PerlPooch/TimeMachine/Hardware/PCB/PCB Back.pdf

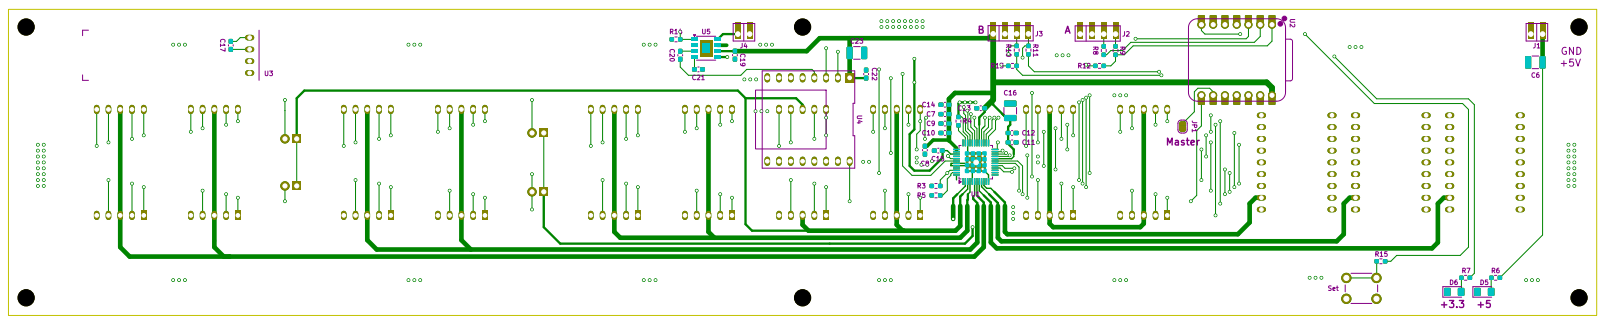
[picture p1: page 1]

Size: USLedger | Rev:
KiCad E.D.A. 10.0.6 | Id: 1/1
