PerlPooch/TimeMachine/Hardware/PCB/PCB Front.pdf

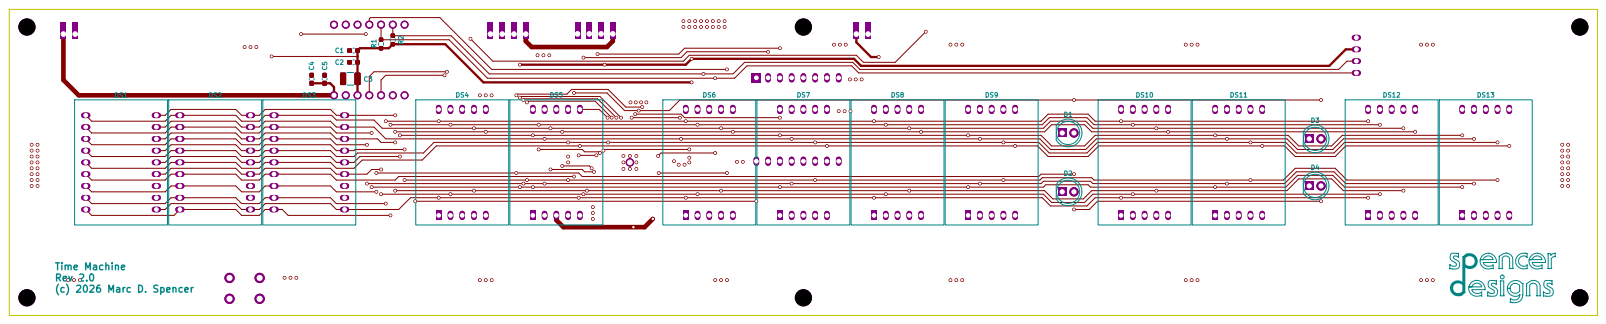
[picture p2: page 1]

Size: USLedger | Rev:
KiCad E.D.A. 10.0.6 | Id: 1/1
