PerlPooch/TimeMachine/Hardware/PCB/PCB.pdf

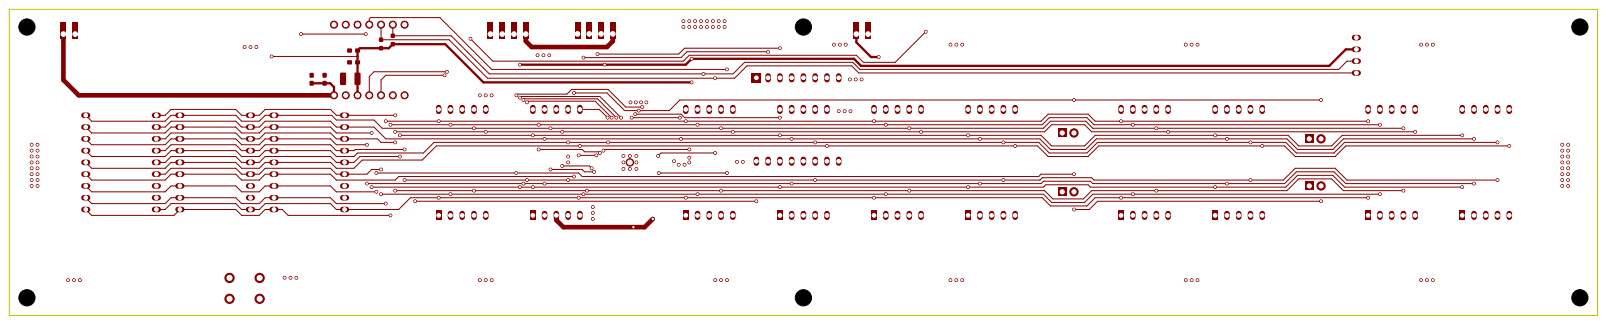
[picture p3: page 1]

Size: USLedger | Rev:
KiCad E.D.A. 10.0.6 | Id: 1/8

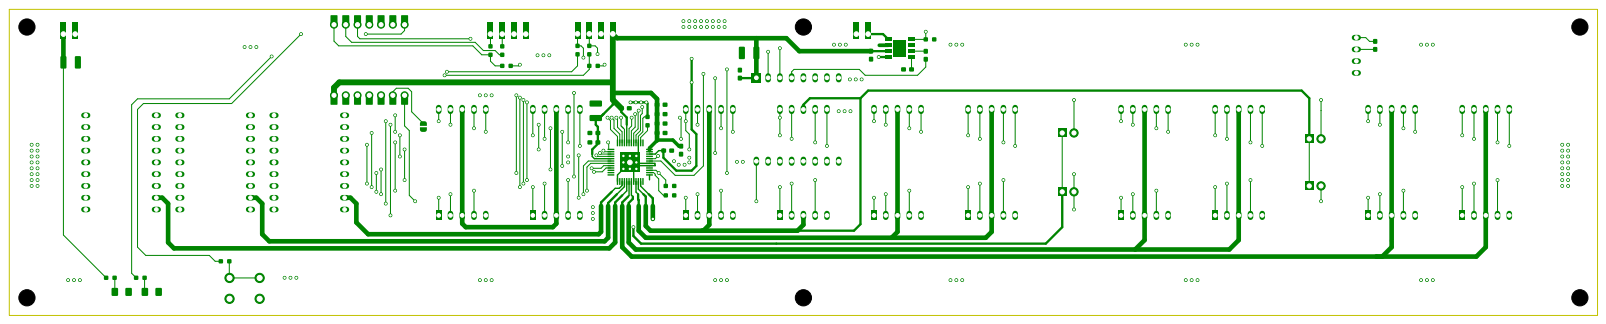
[picture p4: page 2]

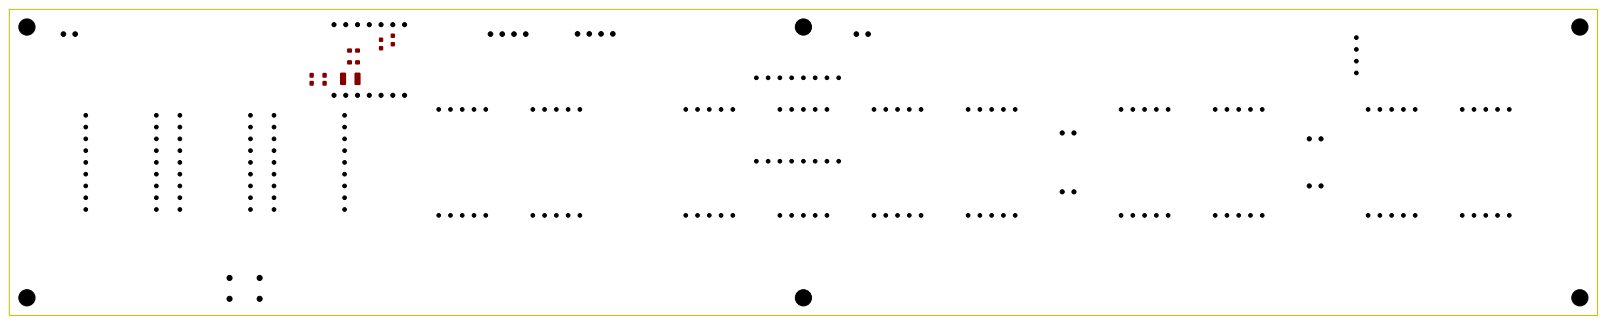
[picture p5: page 3]

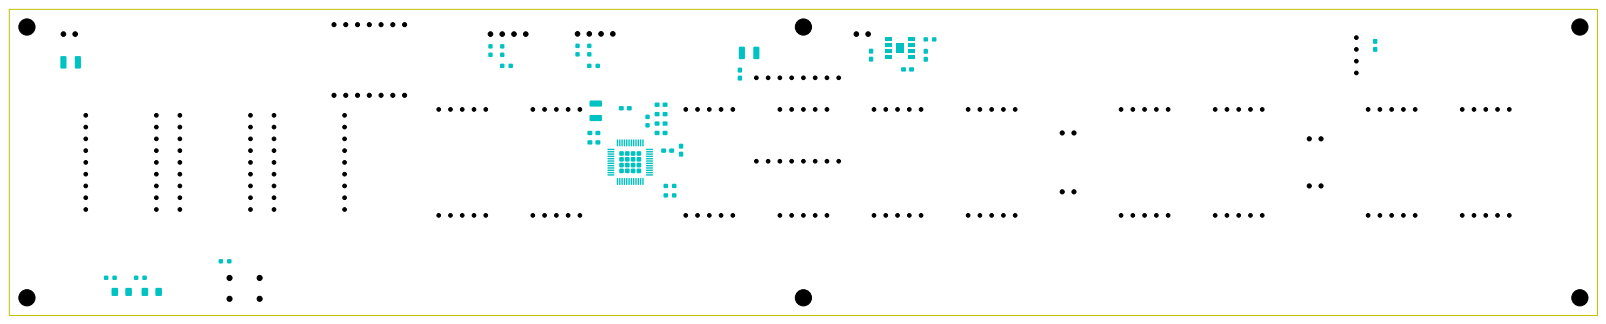
[picture p6: page 4]

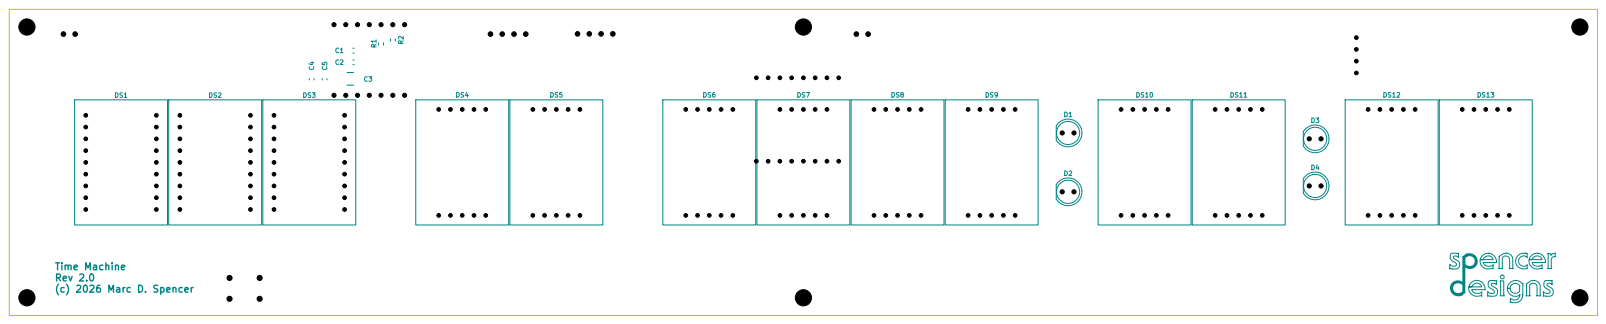
[picture p7: page 5]

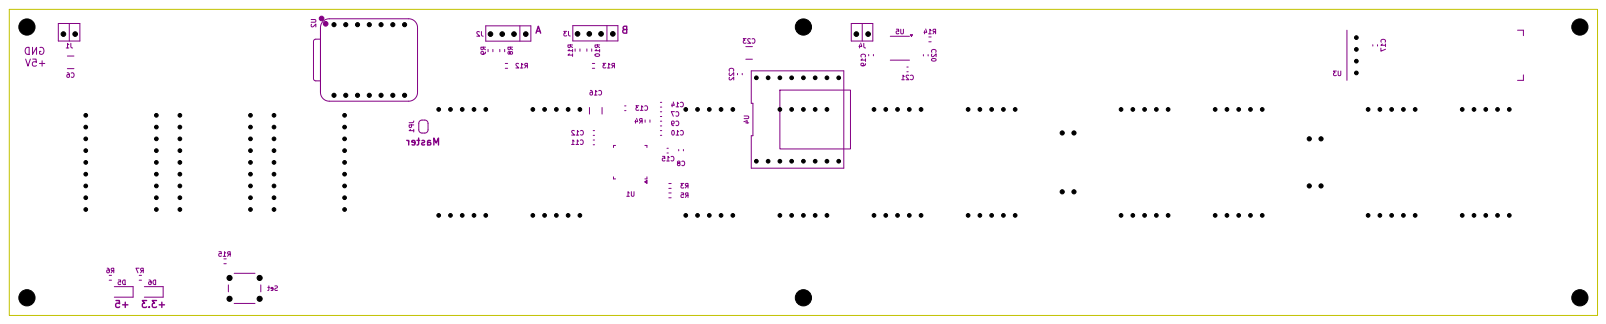
[picture p8: page 6]

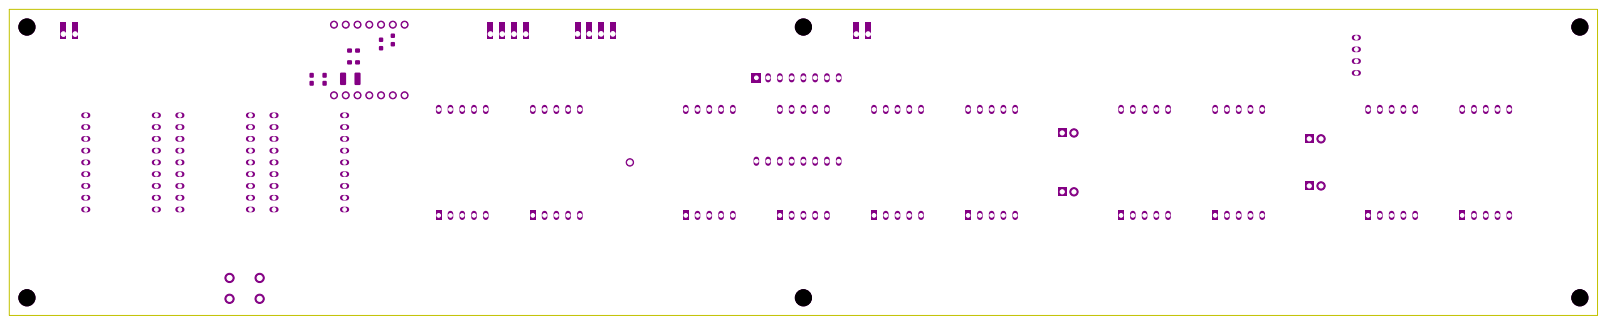
[picture p9: page 7]

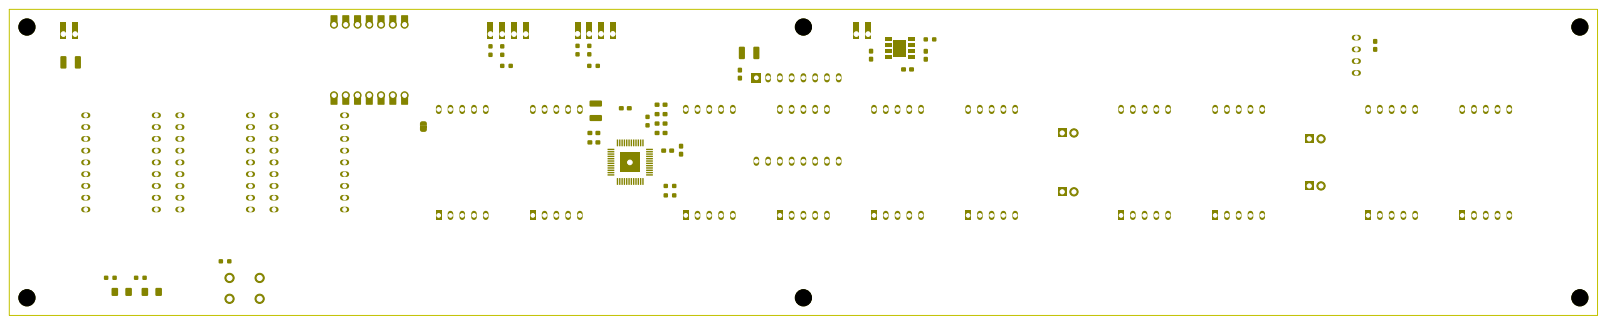
[picture p10: page 8]
