PerlPooch/TimeMachine/Hardware/PCB/Schematic.pdf

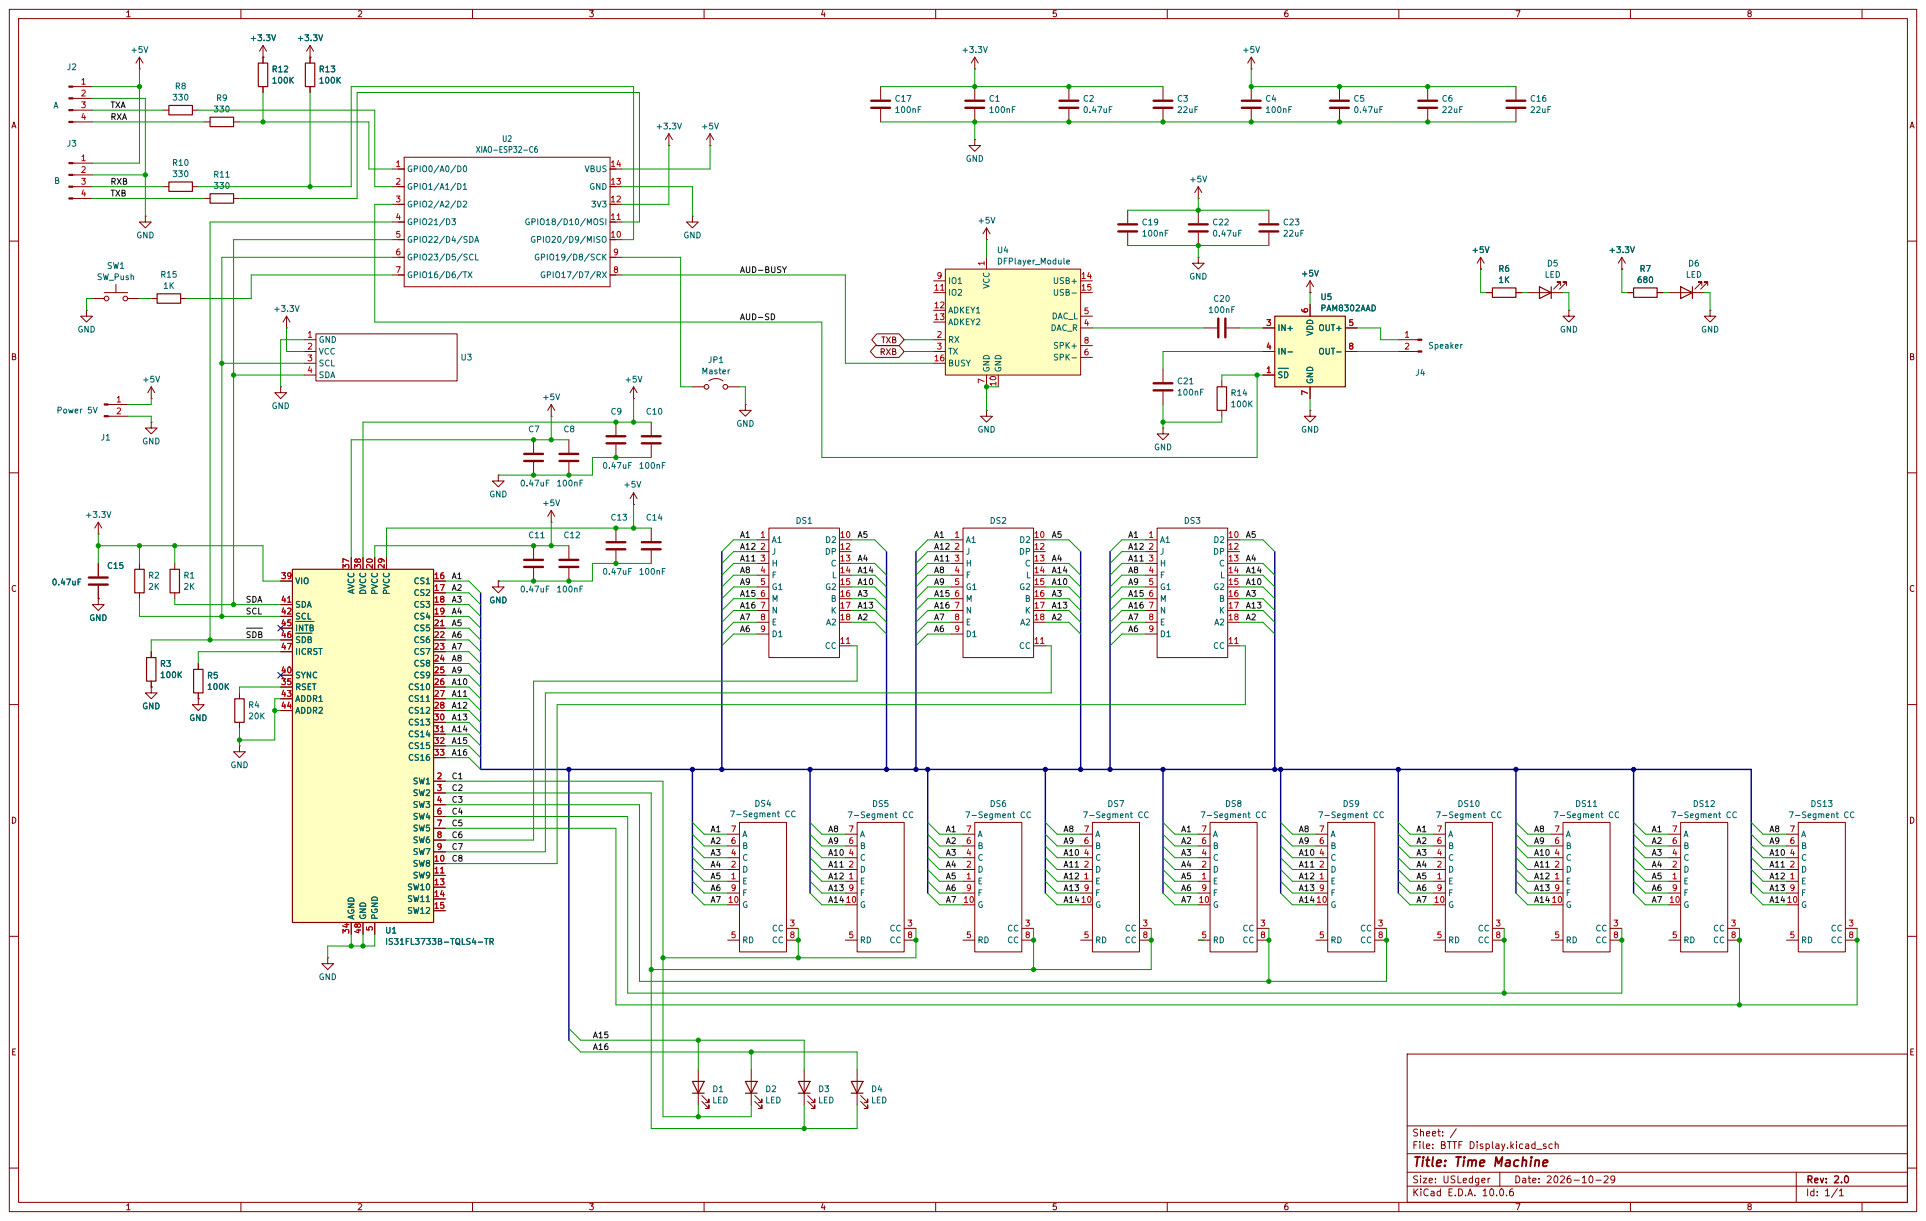
[picture p11: page 1]

SCL 42 | A4
INTB 45 | A5

Size: USLedger | Rev: 2.0
KiCad E.D.A. 10.0.6 | Id: 1/1
