PerlPooch/TimeMachine/Hardware/PCB/BTTF Display.kicad_pcb

## KiCad design Hardware/PCB/BTTF Display.kicad_pcb (2026-11-01)

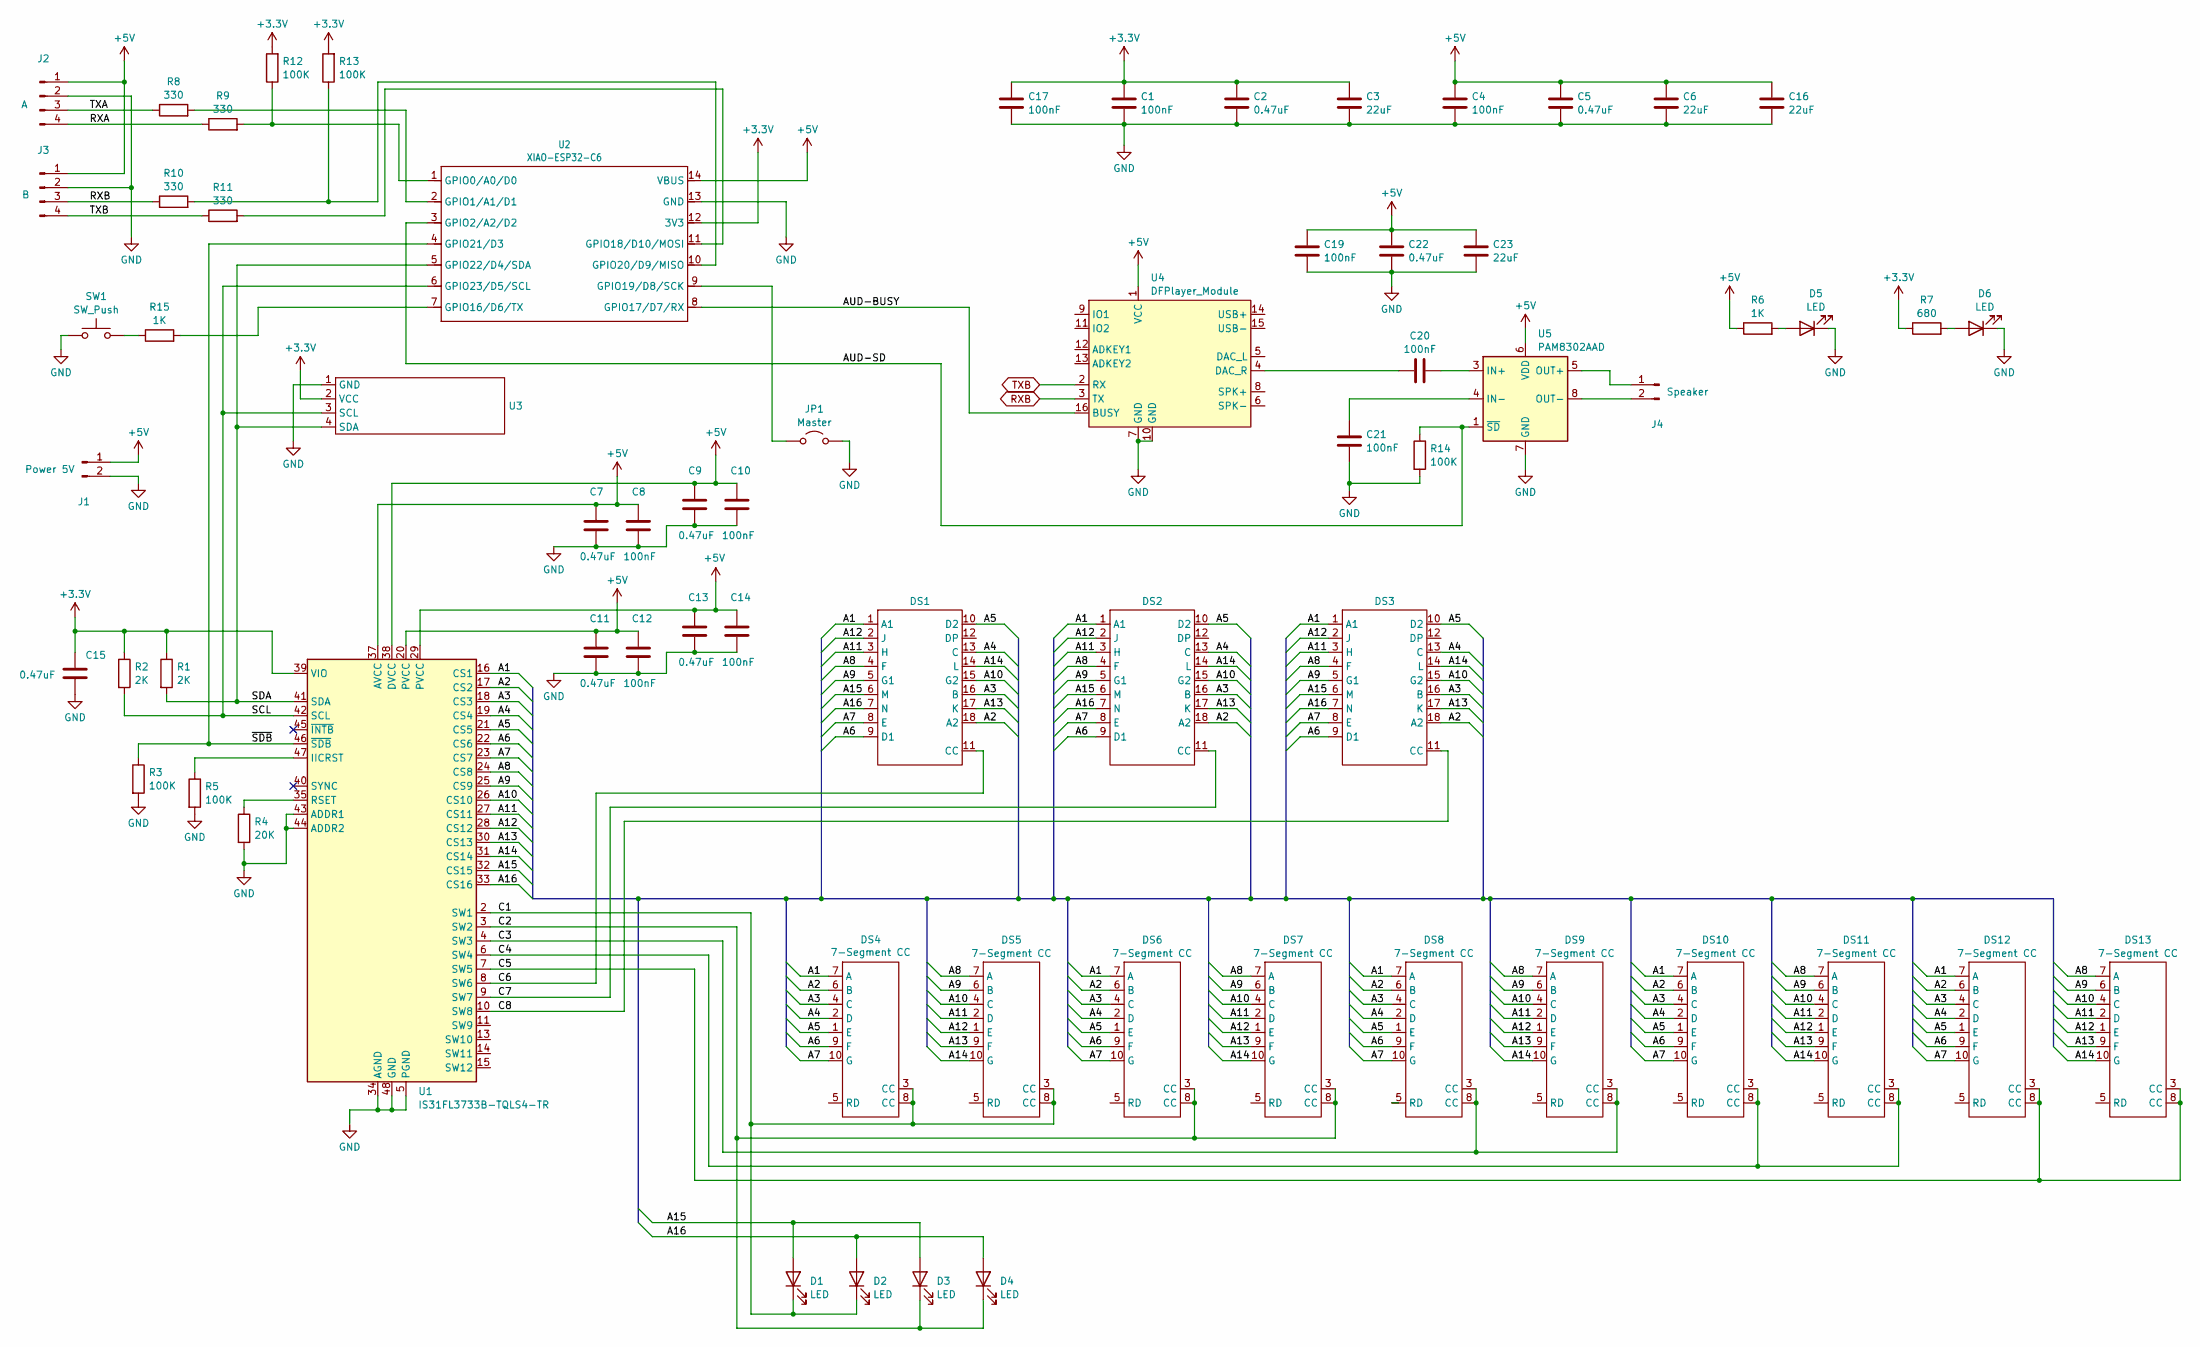
[picture p12: schematic BTTF Display.kicad_sch, Time Machine]

Parts:
C1, C4, C8, C10, C12, C14, C17, C19, C20, C21: 100nF; C_0603_1608Metric_Pad1.08x0.95mm_HandSolder
C2, C5, C7, C9, C11, C13, C15, C22: 0.47uF; C_0603_1608Metric_Pad1.08x0.95mm_HandSolder
C3, C6, C16, C23: 22uF; C_1210_3225Metric_Pad1.33x2.70mm_HandSolder
D1, D2, D3, D4: LED; LED_D5.0mm
D5, D6: LED; LED_1206_3216Metric_Pad1.42x1.75mm_HandSolder
DS1, DS2, DS3: LED Display 16-Segment 0.8in
DS4, DS5, DS6, DS7, DS8, DS9, DS10, DS11, DS12, DS13: 7-Segment CC; LED Display 7-Segment 0.8in 10-pin
J1: Power 5V; Connector SIP-2-Soldertail-R
J2: A; Connector SIP-4-Soldertail-L
J3: B; Connector SIP-4-Soldertail-L
J4: Speaker; Connector SIP-2-Soldertail-R
JP1: Master; SolderJumper-2_P1.3mm_Open_RoundedPad1.0x1.5mm
R1, R2: 2K; R_0603_1608Metric_Pad0.98x0.95mm_HandSolder
R3, R5, R12, R13, R14: 100K; R_0603_1608Metric_Pad0.98x0.95mm_HandSolder
R4: 20K; R_0603_1608Metric_Pad0.98x0.95mm_HandSolder
R6, R15: 1K; R_0603_1608Metric_Pad0.98x0.95mm_HandSolder
R7: 680; R_0603_1608Metric_Pad0.98x0.95mm_HandSolder
R8, R9, R10, R11: 330; R_0603_1608Metric_Pad0.98x0.95mm_HandSolder
SW1: SW_Push; SW_PUSH_6mm_H4.3mm
U1: IS31FL3733B-TQLS4-TR; TQFP-48-1EP_7x7mm_P0.5mm_EP5x5mm
U2: XIAO-ESP32-C6; XIAO-ESP32C6-DIP
U3: SSD1306-128x32_Borderless
U4: DFPlayer_Module; DFPlayer
U5: PAM8302AAD; Diodes_SO-8EP

Connections:
+3.3V: C1.1, C2.1, C3.1, C15.1, C17.1, R1.1, R2.1, R7.1, R12.2, R13.2, U1.39 (VIO), U2.12 (3V3), U3.2 (VCC)
+5V: C4.1, C5.1, C6.1, C7.1, C8.1, C9.1, C10.1, C11.1, C12.1, C13.1, C14.1, C16.1, C19.1, C22.1, C23.1, J1.1, J2.1, J3.1, R6.1, U1.20 (PVCC), U1.29 (PVCC), U1.37 (AVCC), U1.38 (DVCC), U2.14 (VBUS), U4.1 (VCC), U5.6 (VDD)
/A1: DS1.1 (A1), DS2.1 (A1), DS3.1 (A1), DS4.7 (A), DS6.7 (A), DS8.7 (A), DS10.7 (A), DS12.7 (A), U1.16 (CS1)
/A2: DS1.18 (A2), DS2.18 (A2), DS3.18 (A2), DS4.6 (B), DS6.6 (B), DS8.6 (B), DS10.6 (B), DS12.6 (B), U1.17 (CS2)
/A3: DS1.16 (B), DS2.16 (B), DS3.16 (B), DS4.4 (C), DS6.4 (C), DS8.4 (C), DS10.4 (C), DS12.4 (C), U1.18 (CS3)
/A4: DS1.13 (C), DS2.13 (C), DS3.13 (C), DS4.2 (D), DS6.2 (D), DS8.2 (D), DS10.2 (D), DS12.2 (D), U1.19 (CS4)
/A5: DS1.10 (D2), DS2.10 (D2), DS3.10 (D2), DS4.1 (E), DS6.1 (E), DS8.1 (E), DS10.1 (E), DS12.1 (E), U1.21 (CS5)
/A6: DS1.9 (D1), DS2.9 (D1), DS3.9 (D1), DS4.9 (F), DS6.9 (F), DS8.9 (F), DS10.9 (F), DS12.9 (F), U1.22 (CS6)
/A7: DS1.8 (E), DS2.8 (E), DS3.8 (E), DS4.10 (G), DS6.10 (G), DS8.10 (G), DS10.10 (G), DS12.10 (G), U1.23 (CS7)
/A8: DS1.4 (F), DS2.4 (F), DS3.4 (F), DS5.7 (A), DS7.7 (A), DS9.7 (A), DS11.7 (A), DS13.7 (A), U1.24 (CS8)
/A9: DS1.5 (G1), DS2.5 (G1), DS3.5 (G1), DS5.6 (B), DS7.6 (B), DS9.6 (B), DS11.6 (B), DS13.6 (B), U1.25 (CS9)
/A10: DS1.15 (G2), DS2.15 (G2), DS3.15 (G2), DS5.4 (C), DS7.4 (C), DS9.4 (C), DS11.4 (C), DS13.4 (C), U1.26 (CS10)
/A11: DS1.3 (H), DS2.3 (H), DS3.3 (H), DS5.2 (D), DS7.2 (D), DS9.2 (D), DS11.2 (D), DS13.2 (D), U1.27 (CS11)
/A12: DS1.2 (J), DS2.2 (J), DS3.2 (J), DS5.1 (E), DS7.1 (E), DS9.1 (E), DS11.1 (E), DS13.1 (E), U1.28 (CS12)
/A13: DS1.17 (K), DS2.17 (K), DS3.17 (K), DS5.9 (F), DS7.9 (F), DS9.9 (F), DS11.9 (F), DS13.9 (F), U1.30 (CS13)
/A14: DS1.14 (L), DS2.14 (L), DS3.14 (L), DS5.10 (G), DS7.10 (G), DS9.10 (G), DS11.10 (G), DS13.10 (G), U1.31 (CS14)
/A15: D1.2 (A), D3.2 (A), DS1.6 (M), DS2.6 (M), DS3.6 (M), U1.32 (CS15)
/A16: D2.2 (A), D4.2 (A), DS1.7 (N), DS2.7 (N), DS3.7 (N), U1.33 (CS16)
/AUD-BUSY: U2.8 (GPIO17/D7/RX), U4.16 (BUSY)
/AUD-SD: R14.1, U2.3 (GPIO2/A2/D2), U5.1 (~SD)
/C1: D1.1 (K), D2.1 (K), DS4.3 (CC), DS4.8 (CC), DS5.3 (CC), DS5.8 (CC), U1.2 (SW1)
/C2: D3.1 (K), D4.1 (K), DS6.3 (CC), DS6.8 (CC), DS7.3 (CC), DS7.8 (CC), U1.3 (SW2)
/C3: DS8.3 (CC), DS8.8 (CC), DS9.3 (CC), DS9.8 (CC), U1.4 (SW3)
/C4: DS10.3 (CC), DS10.8 (CC), DS11.3 (CC), DS11.8 (CC), U1.6 (SW4)
/C5: DS12.3 (CC), DS12.8 (CC), DS13.3 (CC), DS13.8 (CC), U1.7 (SW5)
/C6: DS1.11 (CC), U1.8 (SW6)
/C7: DS2.11 (CC), U1.9 (SW7)
/C8: DS3.11 (CC), U1.10 (SW8)
/RXA: J2.4, R9.1
/SCL: R2.2, U1.42 (SCL), U2.6 (GPIO23/D5/SCL), U3.3 (SCL)
/SDA: R1.2, U1.41 (SDA), U2.5 (GPIO22/D4/SDA), U3.4 (SDA)
/TXA: J2.3, R8.1
/~SDB: R3.1, U1.46 (~SDB), U2.4 (GPIO21/D3)
GND: C1.2, C2.2, C3.2, C4.2, C5.2, C6.2, C7.2, C8.2, C9.2, C10.2, C11.2, C12.2, C13.2, C14.2, C15.2, C16.2, C17.2, C19.2, C21.1, C22.2, C23.2, D5.1 (K), D6.1 (K), J1.2, J2.2, J3.2, JP1.2 (B), R3.2, R4.2, R5.2, R14.2, SW1.1, U1.5 (PGND), U1.12 (PGND), U1.34 (AGND), U1.43 (ADDR1), U1.44 (ADDR2), U1.48 (GND), U1.49 (GND), U2.13 (GND), U3.1 (GND), U4.7 (GND), U4.10 (GND), U5.7 (GND)
unnamed: D5.2 (A), R6.2
unnamed: D6.2 (A), R7.2
unnamed: J4.1, U5.5 (OUT+)
unnamed: J4.2, U5.8 (OUT-)
unnamed: JP1.1 (A), U2.9 (GPIO19/D8/SCK)
unnamed: R15.1, SW1.2
unnamed: R5.1, U1.47 (IICRST)
unnamed: R4.1, U1.35 (RSET)
unnamed: R9.2, R12.1, U2.1 (GPIO0/A0/D0)
unnamed: R8.2, U2.2 (GPIO1/A1/D1)
unnamed: R15.2, U2.7 (GPIO16/D6/TX)
unnamed: R11.2, U2.11 (GPIO18/D10/MOSI)
unnamed: R10.2, R13.1, U2.10 (GPIO20/D9/MISO)
unnamed: C20.1, U4.4 (DAC_R)
unnamed: C20.2, U5.3 (IN+)
unnamed: C21.2, U5.4 (IN-)
RXB: J3.3, R10.1, U4.3 (TX)
TXB: J3.4, R11.1, U4.2 (RX)

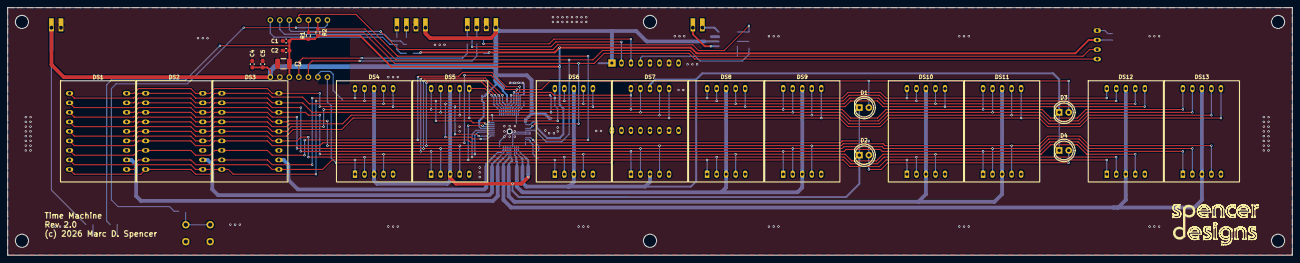
[picture p13: board BTTF Display.kicad_pcb from above]

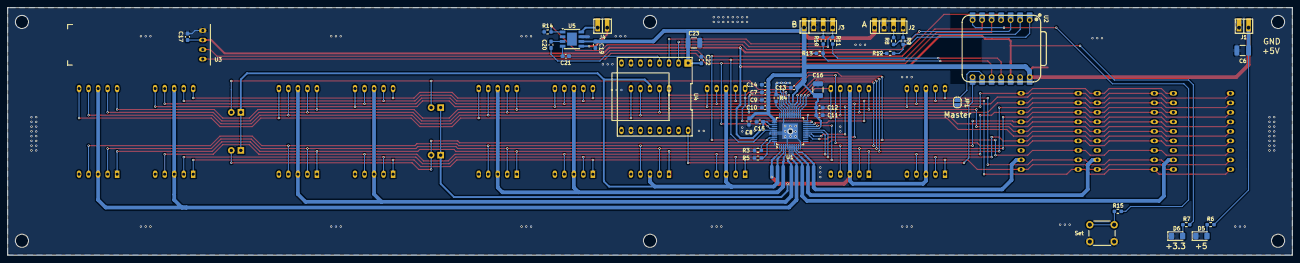
[picture p14: board BTTF Display.kicad_pcb from below]

Board: 2 copper layers, 342.9 x 66.0 mm, 67 parts (43 on the bottom side), 52 nets.
