PerlPooch/TimeMachine/Firmware/TimeMachine/Application.cpp

/*
 * ===========================================================================
 * File:      TimeMachine/Application.cpp
 * Firmware:  0.5.1
 * Git base:  1e4e91f4dbce
 *
 * Copyright (c) 2026 Marc D. Spencer.
 * All Rights Reserved under the applicable license.
 * SPDX-License-Identifier: MPL-2.0
 *
 * This Source Code Form is subject to the terms of the Mozilla Public
 * License, v. 2.0. If a copy of the MPL was not distributed with this
 * file, You can obtain one at https://mozilla.org/MPL/2.0/.
 * ===========================================================================
 */

#include "Application.h"
#include <MDS_Display.h>
#include "SystemConfig.h"
#include <LittleFS.h>
#include <WiFi.h>
#include <esp_wifi.h>
#include "SerialProtocol.h"

#ifdef DEBUG_SERIAL_FRAMES
static void logSerialFrame(const char* port, const char* direction, const uint8_t* payload, size_t length) {
	Serial.print("Serial ");
	Serial.print(port);
	Serial.print(direction);
	Serial.write(payload, length);
	Serial.println();
}

static void logSerialTransmit(size_t index, const uint8_t* frame, size_t length) {
	logSerialFrame(index == 0 ? "A" : "B", " TX: ", frame + 1, length - 2);
}
#endif

// Wire owned services to the hardware and command queue supplied at construction.
Application::Application(Mode mode, MatrixDriver& matrix, MDS_Display& oled, Button& button):
	mode_(mode),
	matrix_(matrix),
	oled_(oled),
	button_(button),
	display_(matrix),
	api_(http_, config_, matrix_, display_.commands(), &weather_),
	timeController_(time_, config_, oled_), weatherController_(weather_, config_),
	clock_(time_, config_, display_.commands(), oled_), tests_(matrix_, display_, oled_) {}

// Provide readable lifecycle names for transition reports.
const char* Application::stateName(State state) {
	switch (state) {
		case State::Uninitialized: return "Uninitialized";
		case State::Starting: return "Starting";
		case State::SegmentTest: return "SegmentTest";
		case State::Running: return "Running";
		case State::DisplayFault: return "DisplayFault";
		case State::ConfigFault: return "ConfigFault";
		case State::ResetHeld: return "ResetHeld";
		case State::Resetting: return "Resetting";
		case State::ResetFailed: return "ResetFailed";
		case State::Rebooting: return "Rebooting";
	}
	return "Unknown";
}

// All lifecycle changes and their one-time entry actions pass through this method.
void Application::transitionTo(State next) {
	if (state_ == next) {
		return;
	}
	// Entry actions may transition again if initialization fails.
	const State previous = state_;
	state_ = next;
	Serial.printf("Application: %s -> %s\n", stateName(previous), stateName(next));

	switch (next) {
		case State::SegmentTest:
			if (!display_.begin() || !display_.lampTest()) {
				Serial.println("Startup: Matrix initialization failed");
				transitionTo(State::DisplayFault);
			} else {
				Serial.println("Startup: Segment test");
			}
			break;

		case State::Running:
			// A reset release resumes the already initialized mode and its timers.
			if (previous == State::SegmentTest && !beginMode()) {
				transitionTo(State::DisplayFault);
			}
			break;

		case State::DisplayFault:
			Serial.println("Display: unavailable; application services remain active");
			if (oledReady_) {
				oled_.D("Display unavailable");
			}
			break;

		case State::ResetHeld:
			resumeState_ = previous;
			// A physical reset press takes priority over the startup animation.
			if (previous == State::SegmentTest) {
				// Resolve where a short press will return before showing RST.
				resumeState_ = display_.cancelLampTest() && beginMode()
					? State::Running : State::DisplayFault;
			}
			resetPressedAt_ = millis();
			showReset();
			Serial.println("Reset: Hold for 5 seconds to clear all settings");
			break;

		case State::Resetting:
			factoryReset();
			break;

		case State::Rebooting:
			Serial.println("Rebooting.");
			// Leave the reset confirmation visible; network reboots are immediate.
			if (previous == State::Resetting) {
				delay(2000);
			}
			ESP.restart();
			break;

		case State::Uninitialized:
		case State::Starting:
		case State::ConfigFault:
		case State::ResetFailed:
			break;
	}
}

// Register the running firmware version, load settings, and select initial display limits.
bool Application::beginConfig(const char* version, bool defaultPrimary) {
	if (!config_.setSettings(SystemConfig::Settings)) {
		Serial.println(config_.lastError());
		return false;
	}

	// Use the sketch version for status; saved files must never select a firmware version.
	JsonDocument status;
	status["version"] = version;
	status["primary"] = defaultPrimary;

	// Seed the role from the jumper before loading any saved primary value.
	if (!config_.setReadOnly("version", status["version"])
		|| !config_.set("primary", status["primary"])) {
		Serial.println(config_.lastError());
		return false;
	}

	// Recover an uninitialized or damaged config filesystem; Wi-Fi NVS is separate.
	bool configReady = config_.setup();

	if (!configReady) {
		Serial.println("Config: mount failed; formatting config filesystem");
		configReady = config_.setup(true);
		Serial.println(configReady ? "Config: filesystem recovered; using defaults" : config_.lastError());
	}

	// A load failure leaves the application using its in-memory settings.
	if (configReady && config_.exists() && !config_.load()) {
		Serial.println(config_.lastError());
	}

	// Select persisted current before Display initializes the matrix.
	if (!matrix_.setConfiguredCurrent(config_.get("gcc").as<uint8_t>())) {
		return false;
	}
	matrix_.setBrightnessLimit(config_.get("pwm").as<uint8_t>());

	return true;
}

// Start shared services and the lamp animation using reported hardware readiness.
bool Application::begin(const char* version, bool defaultPrimary, bool busReady, bool oledReady) {
	// Guard against calls to begin() except from Uninitialized or ConfigFault
	if (state_ != State::Uninitialized && state_ != State::ConfigFault) {
		// A paused running mode still counts as initialized.
		return state_ == State::SegmentTest || state_ == State::Running
			|| ((state_ == State::ResetHeld || state_ == State::ResetFailed)
				&& resumeState_ == State::Running);
	}

	oledReady_ = oledReady;
	transitionTo(State::Starting);

	if (!beginConfig(version, defaultPrimary)) {
		transitionTo(State::ConfigFault);
		return false;
	}

	serialA_.begin(115200, SERIAL_8N1, 0, 1);
	serialB_.begin(115200, SERIAL_8N1, 20, 18);
	config_.dump();
	const char* boardRole = config_.get("primary").as<bool>() ? "Primary" : "Secondary";
	Serial.print("Board: Rev A / ");
	Serial.println(boardRole);
	Serial.println(mode_ == Mode::Clock ? "Application: Clock" : "Application: Tests");

	if (mode_ == Mode::Tests) {
		tests_.printConfig();
	}

	if (oledReady_) {
		oled_.D(config_.get("name").as<const char*>());
		oled_.D(String("V ") + version + " / Rev A");
		oled_.D(boardRole);
		oled_.D("Starting WiFi...");
	} else {
		Serial.println("OLED unavailable");
	}

	if (!busReady) {
		Serial.println("I2C initialization failed; matrix disabled");
	}

	wifi_.setStatusCallback([this](const String& message) {
		if (oledReady_) {
			oled_.D(message);
		}
	});

	MDS_WiFi::Options wifiOptions;
	wifiOptions.accessPointPrefix = "Time Machine";
	wifiOptions.portalTitle = "Time Machine Configuration";
	// Keep A/B reception active during both saved-network retries and provisioning.
	wifiOptions.connectionPolicy = MDS_WiFi::ConnectionPolicy::RetrySavedNetworkAsync;
	Serial.println("Startup: beginning WiFi");
	const bool wifiStarted = wifi_.begin(wifiOptions);
	Serial.println(wifi_.ready() ? "Startup: WiFi online" :
		(wifiStarted ? "Startup: WiFi waiting for station/IP" : "Startup: WiFi retrying in loop"));

	api_.setSerialRouter([this](uint8_t destinations, const char* payload, size_t length) {
		return routeSerialPayload(destinations, payload, length);
	});
	api_.setDisplayRouter([this](const Display::DisplayCommand& command) { return routeDisplayCommand(command); });

	// Absolute offset inputs use real UTC, independently of the stored display offset.
	api_.setTimeSource([this](int64_t& utc) {
		if (!time_.valid()) return false;

		utc = static_cast<int64_t>(time_.utcNow());
		return true;
	});

	api_.begin();
	serviceHttp();

	time_.setStatusCallback([this](const String& message) {
		Serial.println(message);
		if (oledReady_) {
			oled_.D(message);
			// Repeat the current IP after NTP's startup messages.
			if (message == "Time: synchronized" && wifi_.ready()) {
				oled_.D(WiFi.localIP().toString());
			}
		}
	});
	timeController_.begin(oledReady_);

	weather_.setStatusCallback([this](const String& message) {
		Serial.println(message);

		// Apply timezone only after the weather service accepts a successful result.
		if (message == "Weather: updated") {
			weatherController_.applyTimezone();
		}
	});

	weatherController_.tick(wifi_.ready(), time_.valid());

	// A missing display still permits network and configuration services.
	transitionTo(busReady ? State::SegmentTest : State::DisplayFault);
	Serial.println("Startup: Setup complete");
	return state_ == State::SegmentTest;
}

// Start the selected display behavior after the lamp animation completes.
bool Application::beginMode() {
	switch (mode_) {
		case Mode::Tests:
			Serial.println("Startup: Beginning display test");
			return tests_.begin();
		case Mode::Clock:
			Serial.println("Startup: Clock");
			return clock_.begin();
	}
	return false;
}

// Start or stop the HTTP listener as station connectivity changes.
void Application::serviceHttp() {
	if (wifi_.ready()) {
		if (!http_.running()) {
			http_.begin();
			Serial.println("HTTP: listening on port 80");
		}
	} else if (http_.running()) {
		http_.stop();
	}
}

// Receive length-delimited frames and dispatch them by payload type.
void Application::receiveSerial(HardwareSerial& port, SerialProtocol::Receiver& receiver, size_t index, const char* name) {
	using Result = SerialProtocol::Receiver::Result;
	using Status = SerialProtocol::Status;
	auto& response = serialResponse_[index];

	// Retain one response per port and leave further input in the UART until it drains.
	if (response.pending) return;

	auto report = [&](Result result) {
		if (result == Result::None) {
			return;
		}

		uint32_t primaryMillis = 0;
		const bool timestampedPing = result == Result::Message
			&& SerialProtocol::decodePing(receiver.payload(), receiver.length(), primaryMillis);
		// Capture the offset before USB diagnostic output can delay this service pass.
		if (timestampedPing && !config_.get("primary").as<bool>()) {
			display_.synchronizeMillis(primaryMillis);
		}
#ifdef DEBUG_SERIAL_FRAMES
		if (result == Result::Message) {
			logSerialFrame(name, " RX: ", receiver.payload(), receiver.length());
		}
#endif

		size_t first = 0;
		while (result == Result::Message && first < receiver.length()
			&& (receiver.payload()[first] == ' ' || receiver.payload()[first] == '\t'
				|| receiver.payload()[first] == '\r' || receiver.payload()[first] == '\n')) {
			++first;
		}

		JsonDocument payload;
		const bool object = result == Result::Message && first < receiver.length()
			&& receiver.payload()[first] == '{'
			&& !deserializeJson(payload, receiver.payload(), receiver.length()) && payload.is<JsonObject>();

		// Reserve status objects as responses, including unknown future status values.
		// Recognizing JSON rather than literal bytes also accepts normal JSON whitespace.
		if (object && payload["status"].is<const char*>()) {
			return;
		}

		// Receipt acknowledgment is determined by framing, before application validation.
		response.pending = true;
		response.sent = 0;
		switch (result) {
			case Result::Message: response.status = Status::Ok; break;
			case Result::InvalidLength: response.status = Status::ErrorLength; break;
			case Result::InvalidTerminator: response.status = Status::ErrorTerminator; break;
			case Result::Timeout: response.status = Status::ErrorTimeout; break;
			case Result::None: break;
		}

		if (object && !payload["ip"].isUnbound()) {
			const JsonString address = payload["ip"].as<JsonString>();

			// Framing is already acknowledged; malformed announcements cannot replace peer status.
			if (payload.size() != 1 || !payload["ip"].is<const char*>()
				|| !receiveIPAddress(address.c_str(), address.size(), index)) {
				Serial.println("Serial: invalid IP announcement");
			}
			return;
		}

		if (result == Result::Message && SerialProtocol::isWiFiCredentials(receiver.payload(), receiver.length())) {
			receiveWiFiCredentials(receiver.payload(), receiver.length(), name);
			return;
		}

		// Handle configuration separately from display commands.
		if (result == Result::Message && first < receiver.length() && receiver.payload()[first] == '[') {
			JsonDocument envelope;
			if (!deserializeJson(envelope, receiver.payload(), receiver.length())
				&& envelope[0].is<const char*>() && strcmp(envelope[0].as<const char*>(), "config1") == 0) {
				if (!api_.receiveConfigCommand(receiver.payload(), receiver.length())) {
					Serial.println("Serial: configuration update failed");
				}
				return;
			}
		}

		if (result == Result::Message) {
			if (!timestampedPing && receiver.length() >= 5 && memcmp(receiver.payload(), "ping ", 5) == 0) {
				Serial.print("Serial "); Serial.print(name); Serial.println(" error: invalid ping timestamp");
			}
			if (receiver.length() && receiver.payload()[0] == '['
				&& !api_.receiveDisplayCommand(receiver.payload(), receiver.length())) {
				Serial.print("Serial "); Serial.print(name); Serial.println(" error: invalid display command");
			}
		} else {
			Serial.print("Serial ");
			Serial.print(name);
			Serial.print(" error: ");
			Serial.println(result == Result::InvalidLength ? "invalid length" :
				result == Result::InvalidTerminator ? "expected newline terminator" : "frame timeout");
		}
	};

	report(receiver.expire(millis()));

	// Bound work per port so continuous traffic cannot monopolize the main loop.
	for (size_t count = 0; count < SerialProtocol::MaxFrameBytes && port.available() && !response.pending; ++count) {
		const int byte = port.read();
		if (byte < 0) {
			break;
		}
		report(receiver.feed(static_cast<uint8_t>(byte), millis()));
	}
}

// Record a direct peer address in runtime-only RO configuration and refresh its expiry timer.
bool Application::receiveIPAddress(const char* address, size_t length, size_t index) {
	if (!SerialProtocol::validIPAddress(address, length)) return false;

	JsonDocument value;
	value["ip"] = address;
	if (!config_.setReadOnly(index == 0 ? "ipA" : "ipB", value["ip"])) return false;

	peerIPAt_[index] = millis();
	peerIPKnown_[index] = length != 0;
	return true;
}

// Announce local IP changes on both links, refresh periodically, and expire silent peers.
void Application::serviceIPAddresses(uint32_t now) {
	String address = wifi_.ready() ? WiFi.localIP().toString() : String("");
	if (!SerialProtocol::validIPAddress(address.c_str(), address.length())) address = "";

	if (strcmp(localIPAddress_, address.c_str()) != 0) {
		strlcpy(localIPAddress_, address.c_str(), sizeof(localIPAddress_));

		for (size_t index = 0; index < 2; ++index) {
			ipAnnouncementDue_[index] = true;
			// Replace an unsent obsolete announcement, but finish any partial frame intact.
			if (serialTransmit_[index].ipAddress && !serialTransmit_[index].sent) {
				serialTransmit_[index] = SerialTransmit{};
			}
		}
	}

	for (size_t index = 0; index < 2; ++index) {
		if (peerIPKnown_[index] && uint32_t(now - peerIPAt_[index]) >= PeerIPExpiryMs) {
			receiveIPAddress("", 0, index);
		}

		auto& pending = serialTransmit_[index];
		if (pending.length || (!ipAnnouncementDue_[index]
			&& (!localIPAddress_[0] || uint32_t(now - lastIPAt_[index]) < IPAnnouncementIntervalMs))) {
			continue;
		}

		pending.length = SerialProtocol::encodeIPAddress(localIPAddress_, pending.frame, sizeof(pending.frame));
		pending.sent = 0;
		pending.credentials = false;
		pending.ipAddress = true;
		if (pending.length) {
			ipAnnouncementDue_[index] = false;
			lastIPAt_[index] = now;
		}
	}
}

// A non-master adopts credentials from either physical link, even while offline.
void Application::receiveWiFiCredentials(const uint8_t* payload, size_t length, const char* portName) {
	Serial.print("Serial ");
	Serial.print(portName);

	if (config_.get("primary").as<bool>()) {
		Serial.println(" WiFi credentials ignored by primary");
		return;
	}

	SerialProtocol::WiFiCredentials credentials;
	if (!SerialProtocol::decodeWiFiCredentials(payload, length, credentials)) {
		Serial.println(" error: invalid WiFi credentials");
		return;
	}

	const bool accepted = wifi_.setCredentials(credentials.ssid, credentials.password);
	Serial.println(accepted ? " WiFi credentials accepted" : " error: WiFi credentials rejected");
}

// Read saved station settings independently of connectivity and queue each idle port.
void Application::queueWiFiCredentials(uint32_t now) {
	bool due[2] = {};
	for (size_t index = 0; index < 2; ++index) {
		due[index] = !serialTransmit_[index].length
			&& uint32_t(now - lastWiFiAt_[index]) >= WiFiBroadcastIntervalMs;
	}
	if (!due[0] && !due[1]) {
		return;
	}

	wifi_config_t saved = {};
	SerialProtocol::WiFiCredentials credentials;
	const bool readable = esp_wifi_get_config(WIFI_IF_STA, &saved) == ESP_OK;
	if (readable) {
		memcpy(credentials.ssid, saved.sta.ssid, 32);
		memcpy(credentials.password, saved.sta.password, 64);
	}

	for (size_t index = 0; index < 2; ++index) {
		if (!due[index]) {
			continue;
		}

		lastWiFiAt_[index] = now;
		if (!readable || !credentials.ssid[0]) {
			continue; // Try again in ten seconds, including after a manual portal save.
		}

		auto& pending = serialTransmit_[index];
		pending.length = SerialProtocol::encodeWiFiCredentials(credentials, pending.frame, sizeof(pending.frame));
		pending.sent = 0;
		pending.credentials = pending.length != 0;
		pending.ipAddress = false;
	}
}

// Encode display-specific content and delegate serial delivery to the shared payload router.
bool Application::routeDisplayCommand(const Display::DisplayCommand& command) {
	char payload[SerialProtocol::MaxPayloadBytes + 1];
	const size_t length = ApplicationApi::encodeDisplayCommand(command, payload, sizeof(payload));

	return length && routeSerialPayload(command.destinations, payload, length);
}

// Reserve all selected ports before queueing a framed payload; local execution remains with the caller.
bool Application::routeSerialPayload(uint8_t destinations, const char* payload, size_t length) {
	for (size_t index = 0; index < 2; ++index) {
		if ((destinations & (index == 0 ? Display::PortA : Display::PortB))
			&& serialTransmit_[index].length) return false;
	}

	uint8_t frame[SerialProtocol::BufferBytes];
	const size_t frameLength = SerialProtocol::encode(payload, length, frame, sizeof(frame));
	if (!frameLength) return false;

	for (size_t index = 0; index < 2; ++index) {
		if (destinations & (index == 0 ? Display::PortA : Display::PortB)) {
			auto& pending = serialTransmit_[index];
			memcpy(pending.frame, frame, frameLength + 1);
			pending.length = frameLength;
			pending.sent = 0;
			pending.credentials = false;
			pending.ipAddress = false;
		}
	}
	return true;
}

// Service both ports independently; all boards announce IPs, and primaries add broadcasts.
void Application::serviceSerial() {
	if (config_.get("primary").as<bool>()) display_.resetMillisDelta();
	receiveSerial(serialA_, receiverA_, 0, "A");
	receiveSerial(serialB_, receiverB_, 1, "B");

	const bool primary = config_.get("primary").as<bool>();
	const uint32_t now = millis();
	if (primary && !primaryActive_) {
		primaryActive_ = true;
		lastPingAt_[0] = lastPingAt_[1] = now - PingIntervalMs;
		lastWiFiAt_[0] = lastWiFiAt_[1] = now - WiFiBroadcastIntervalMs;
	}
	if (primary) {
		queueWiFiCredentials(now);
	}
	serviceIPAddresses(now);

	HardwareSerial* ports[] = {&serialA_, &serialB_};
	bool frameSent[2] = {};
	for (size_t index = 0; index < 2; ++index) {
		auto& pending = serialTransmit_[index];
		// Drop an unsent broadcast after demotion; finish partial frames intact.
		if (!primary && pending.credentials && !pending.sent) {
			pending = SerialTransmit{};
		}

		auto& response = serialResponse_[index];

		// Respond before starting another frame, but never interrupt bytes already sent.
		if (response.pending && !pending.sent) {
			frameSent[index] = true;
			uint8_t frame[SerialProtocol::StatusBufferBytes];
			const size_t length = SerialProtocol::encodeStatus(response.status, frame, sizeof(frame));
			const int room = ports[index]->availableForWrite();
			if (room <= 0) continue;

			const size_t remaining = length - response.sent;
			const size_t count = remaining < static_cast<size_t>(room) ? remaining : static_cast<size_t>(room);
			response.sent += ports[index]->write(frame + response.sent, count);

			if (response.sent == length) {
#ifdef DEBUG_SERIAL_FRAMES
				logSerialTransmit(index, frame, length);
#endif
				response = SerialResponse{};
			}
			continue;
		}

		if (!pending.length) continue;
		frameSent[index] = true;
		const int room = ports[index]->availableForWrite();
		if (room <= 0) continue;
		const size_t remaining = pending.length - pending.sent;
		const size_t count = remaining < static_cast<size_t>(room) ? remaining : static_cast<size_t>(room);
		pending.sent += ports[index]->write(pending.frame + pending.sent, count);
		if (pending.sent == pending.length) {
#ifdef DEBUG_SERIAL_FRAMES
			logSerialTransmit(index, pending.frame, pending.length);
#endif
			pending = SerialTransmit{};
		}
	}
	if (!primary) {
		primaryActive_ = false;
		return;
	}
	uint8_t frame[SerialProtocol::PingBufferBytes];
	const size_t length = SerialProtocol::encodePing(now, frame, sizeof(frame));
	for (size_t index = 0; index < 2; ++index) {
		if (!frameSent[index] && uint32_t(now - lastPingAt_[index]) >= PingIntervalMs
			&& ports[index]->availableForWrite() >= static_cast<int>(length)
			&& ports[index]->write(frame, length) == length) {
			lastPingAt_[index] = now;
#ifdef DEBUG_SERIAL_FRAMES
			logSerialTransmit(index, frame, length);
#endif
		}
	}
}

// Temporarily replace the three alpha digits, retaining the mode's logical frame.
void Application::showReset() {
	resetFrame_ = display_.frame();

	if (!display_.showAlpha("RST")) {
		// Do not resume rendering after an overlay write fails.
		resumeState_ = State::DisplayFault;
		Serial.println("Reset: cannot display RST; button remains active");
	}
}

// Clear application settings and Wi-Fi credentials, rebooting only after both succeed.
void Application::factoryReset() {
	if (!display_.clear()) {
		Serial.println("Reset: cannot blank display; continuing reset");
	}

	Serial.println("Reset: Clearing settings...");
	if (oledReady_) {
		oled_.D("Clearing settings...");
	}

	http_.stop();

	// Remove only configuration files; preserve website content and other files.
	// Clear an unfinished save first, then the active configuration.
	const String configFiles[] = {String(ConfigPath) + ".tmp", ConfigPath};

	for (const auto& path : configFiles) {
		if (LittleFS.exists(path) && !LittleFS.remove(path)) {
			Serial.print("Reset: cannot remove ");
			Serial.println(path);
			transitionTo(State::ResetFailed);
			return;
		}
	}

	if (!wifi_.eraseCredentials()) {
		Serial.println("Reset: Wi-Fi erase failed");
		transitionTo(State::ResetFailed);
		return;
	}

	Serial.println("Reset: settings cleared");
	transitionTo(State::Rebooting);
}

// Handle reset hold, cancellation, and retry without restarting a resumed mode.
void Application::serviceButton() {
	if (button_.tick()) {
		Serial.println(button_.pressed() ? "Reset: pressed" : "Reset: released");
		if (button_.pressed() && oledReady_) {
			oled_.D(WiFi.localIP().toString());
		}
	}

	switch (state_) {
		case State::SegmentTest:
		case State::Running:
		case State::DisplayFault:
			if (button_.pressed()) {
				transitionTo(State::ResetHeld);
			}
			break;

		case State::ResetHeld:
		case State::ResetFailed:
			// A failed erase waits for release; retry requires a fresh press.
			if (!button_.pressed()) {
				if (!matrix_.ready() || !display_.show(resetFrame_)) {
					resumeState_ = State::DisplayFault;
				}
				transitionTo(resumeState_);
			} else if (state_ == State::ResetHeld && button_.rawPressed()
				&& uint32_t(millis() - resetPressedAt_) >= ResetHoldMs) {
				// Raw release cancels at the deadline, even during release debounce.
				transitionTo(State::Resetting);
			}
			break;

		default:
			break;
	}
}

// Service shared work in active states and advance rendering when the lifecycle permits it.
void Application::tick() {
	// These states are handled by begin(), entry actions, or the hardware restart.
	switch (state_) {
		case State::Uninitialized:
		case State::Starting:
		case State::ConfigFault:
		case State::Resetting:
		case State::Rebooting:
			return;
		default:
			break;
	}

	serviceButton();
	// ResetFailed polls only the button; reset/reboot paths do no further work.
	if (state_ == State::Resetting || state_ == State::ResetFailed || state_ == State::Rebooting) {
		return;
	}

	wifi_.tick();
	if (wifi_.rebootRequested()) {
		transitionTo(State::Rebooting);
		return;
	}

	// Shared services keep running during startup, reset holds, and display faults.
	if (mode_ == Mode::Clock) {
		serviceHttp();
		http_.tick();
		serviceSerial();
		timeController_.tick(wifi_.ready());
		weatherController_.tick(wifi_.ready(), time_.valid());
	}
	
	// Startup completion enables the mode; an animation failure disables rendering.
	switch (state_) {
		case State::SegmentTest:
			if (!display_.tick()) {
				transitionTo(State::DisplayFault);
			} else if (!display_.segmentTesting()) {
				transitionTo(State::Running);
			}
			break;

		default:
			break;
	}

	if (state_ == State::Running) {
		switch (mode_) {
			case Mode::Tests:
				tests_.tick();

				break;

			case Mode::Clock:
				clock_.tick();
				break;
		}
		// Display owns queue consumption, rendering, animation, and hardware failures.
		if (!display_.tick() || !matrix_.ready()) {
			transitionTo(State::DisplayFault);
		}
	}

	if (oledReady_) {
		oled_.tick();
	}
}
