PerlPooch/TimeMachine/Firmware/TimeMachine/DisplayGamma.h

/*
 * ===========================================================================
 * File:      TimeMachine/DisplayGamma.h
 * Firmware:  0.5.1
 * Git base:  1e4e91f4dbce
 *
 * Copyright (c) 2026 Marc D. Spencer.
 * All Rights Reserved under the applicable license.
 * SPDX-License-Identifier: MPL-2.0
 *
 * This Source Code Form is subject to the terms of the Mozilla Public
 * License, v. 2.0. If a copy of the MPL was not distributed with this
 * file, You can obtain one at https://mozilla.org/MPL/2.0/.
 * ===========================================================================
 */

#pragma once

#include <stdint.h>
#include "DisplayConfig.h"

namespace DisplayGamma {
	// Perceived brightness -> hardware PWM: round(255 * (level / 255)^2.2).
	// Static read-only data; no runtime floating-point calculation.
	constexpr uint8_t Gamma22[256] = {
		  0,   0,   0,   0,   0,   0,   0,   0,   1,   1,   1,   1,   1,   1,   1,   1,
		  1,   1,   1,   1,   1,   1,   1,   1,   1,   2,   2,   2,   2,   2,   2,   2,
		  3,   3,   3,   3,   3,   4,   4,   4,   4,   5,   5,   5,   5,   6,   6,   6,
		  6,   7,   7,   7,   8,   8,   8,   9,   9,   9,  10,  10,  11,  11,  11,  12,
		 12,  13,  13,  13,  14,  14,  15,  15,  16,  16,  17,  17,  18,  18,  19,  19,
		 20,  20,  21,  22,  22,  23,  23,  24,  25,  25,  26,  26,  27,  28,  28,  29,
		 30,  30,  31,  32,  33,  33,  34,  35,  35,  36,  37,  38,  39,  39,  40,  41,
		 42,  43,  43,  44,  45,  46,  47,  48,  49,  49,  50,  51,  52,  53,  54,  55,
		 56,  57,  58,  59,  60,  61,  62,  63,  64,  65,  66,  67,  68,  69,  70,  71,
		 73,  74,  75,  76,  77,  78,  79,  81,  82,  83,  84,  85,  87,  88,  89,  90,
		 91,  93,  94,  95,  97,  98,  99, 100, 102, 103, 105, 106, 107, 109, 110, 111,
		113, 114, 116, 117, 119, 120, 121, 123, 124, 126, 127, 129, 130, 132, 133, 135,
		137, 138, 140, 141, 143, 145, 146, 148, 149, 151, 153, 154, 156, 158, 159, 161,
		163, 165, 166, 168, 170, 172, 173, 175, 177, 179, 181, 182, 184, 186, 188, 190,
		192, 194, 196, 197, 199, 201, 203, 205, 207, 209, 211, 213, 215, 217, 219, 221,
		223, 225, 227, 229, 231, 234, 236, 238, 240, 242, 244, 246, 248, 251, 253, 255,
	};

	// Convert logical brightness through the fixed gamma table without runtime floating point.
	constexpr uint8_t applyGamma22(uint8_t brightness) {
		return Gamma22[brightness];
	}

	constexpr uint8_t DefaultMaximumPWM = DISPLAY_DEV_MODE ? DISPLAY_DEV_MAX_PWM : 255;

	// Apply gamma once, then scale the corrected value to the selected PWM ceiling.
	inline uint8_t toPWM(uint8_t brightness, uint8_t maximumPWM) {
#if DISPLAY_GAMMA_ENABLED
		const uint8_t pwm = applyGamma22(brightness);
#else
		const uint8_t pwm = brightness;
#endif
		// Scale after gamma so the complete fade spans the full duration.
		return (uint16_t(pwm) * maximumPWM + 127) / 255;
	}

	// Use the normal output profile for callers without an explicit PWM ceiling.
	inline uint8_t toPWM(uint8_t brightness) {
		return toPWM(brightness, DefaultMaximumPWM);
	}
}
