PerlPooch/TimeMachine/(commit log)

2026-10-29 Added Hardware
    [BTTF Display.kicad_pcb, BTTF Display.kicad_sch]
2026-10-30 Rev 2.0 PCB
    Added Audio and moved header locations
    [BTTF Display.kicad_pcb, BTTF Display.kicad_sch]
2026-10-31 Added Audio and Adjusted Physical Layout
    [BTTF Display.kicad_pcb, BTTF Display.kicad_sch]
2026-10-31 Added all as shorthand for a, b, local
    [ApplicationApi.cpp]
2026-11-01 Moved LEDs and button for convenience
    [BTTF Display.kicad_pcb]
2026-11-01 Reorganized and PDFs
    [BTTF Display.kicad_pcb, BTTF Display.kicad_sch]
2026-11-01 Copyright banner
    [partitions.csv]
2026-11-02 Allow PCB jumper to set primary (with software config override)
2026-11-02 Clear only config on reset
    [Application.cpp, Application.h, TimeMachine.ino]
